justiceamoh/bioimpedancelab/eagle/analyzer/small_analyzer.pdf

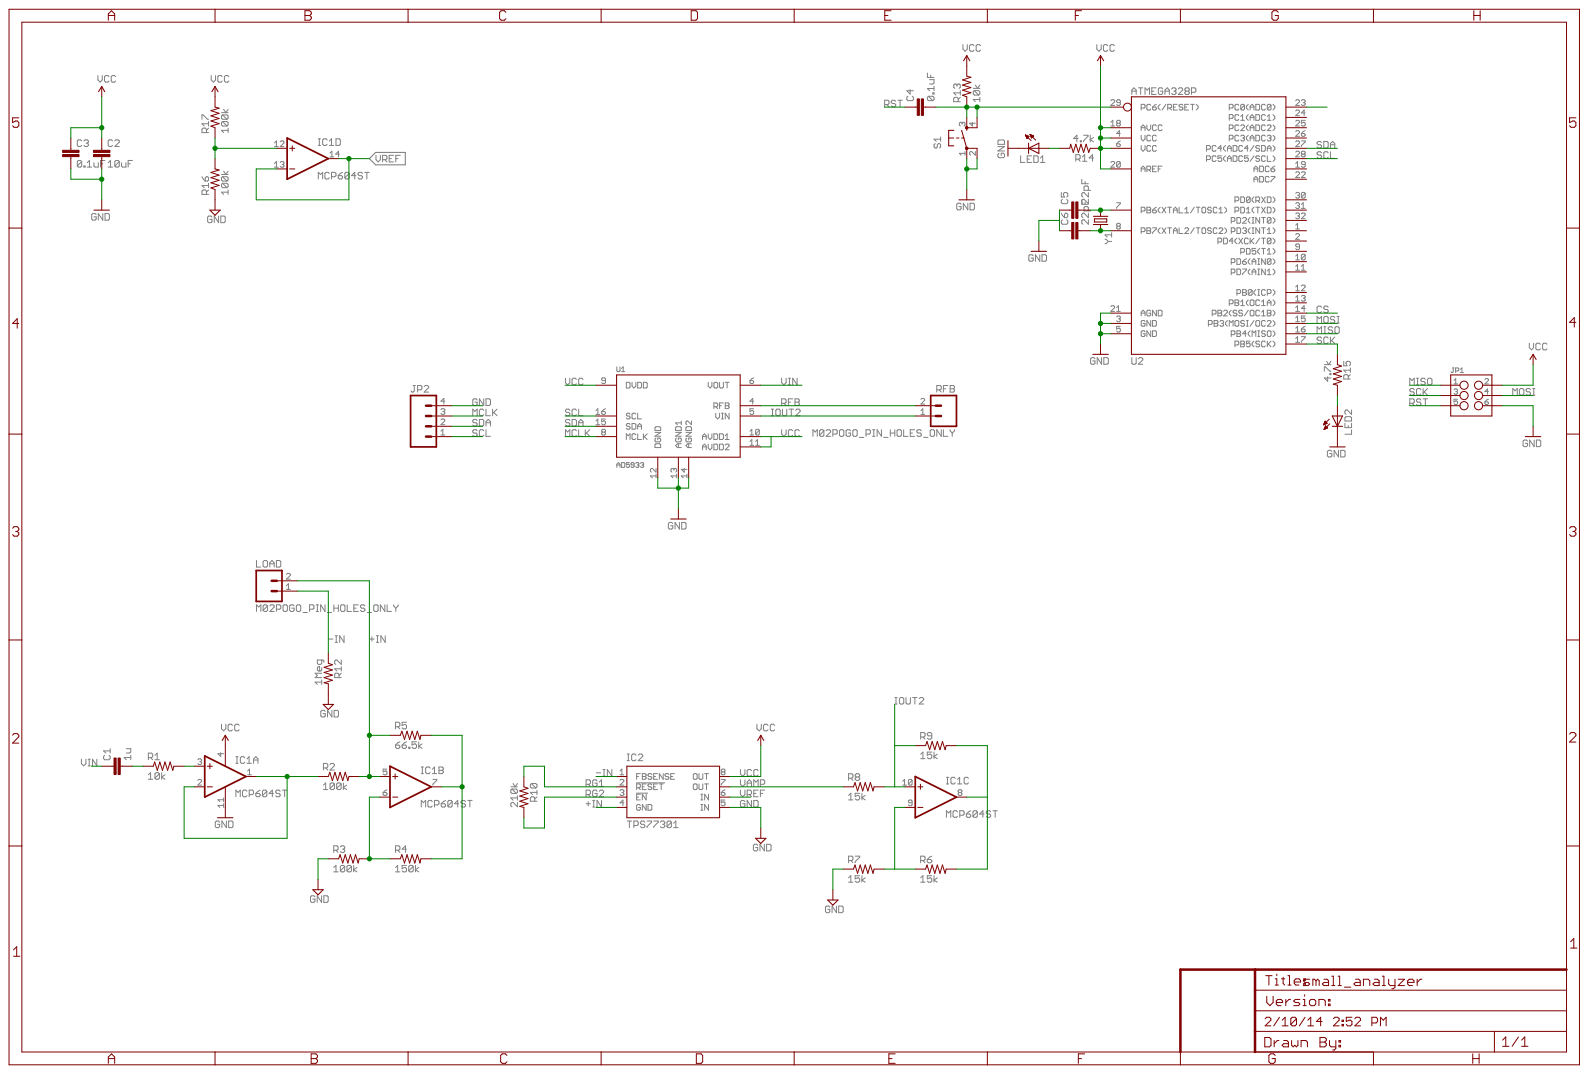
[picture p14: page 1]
