justiceamoh/bioimpedancelab/eagle/analyzer/small_analyzer.brd

## EAGLE design eagle/analyzer/small_analyzer.brd (2014-03-24)

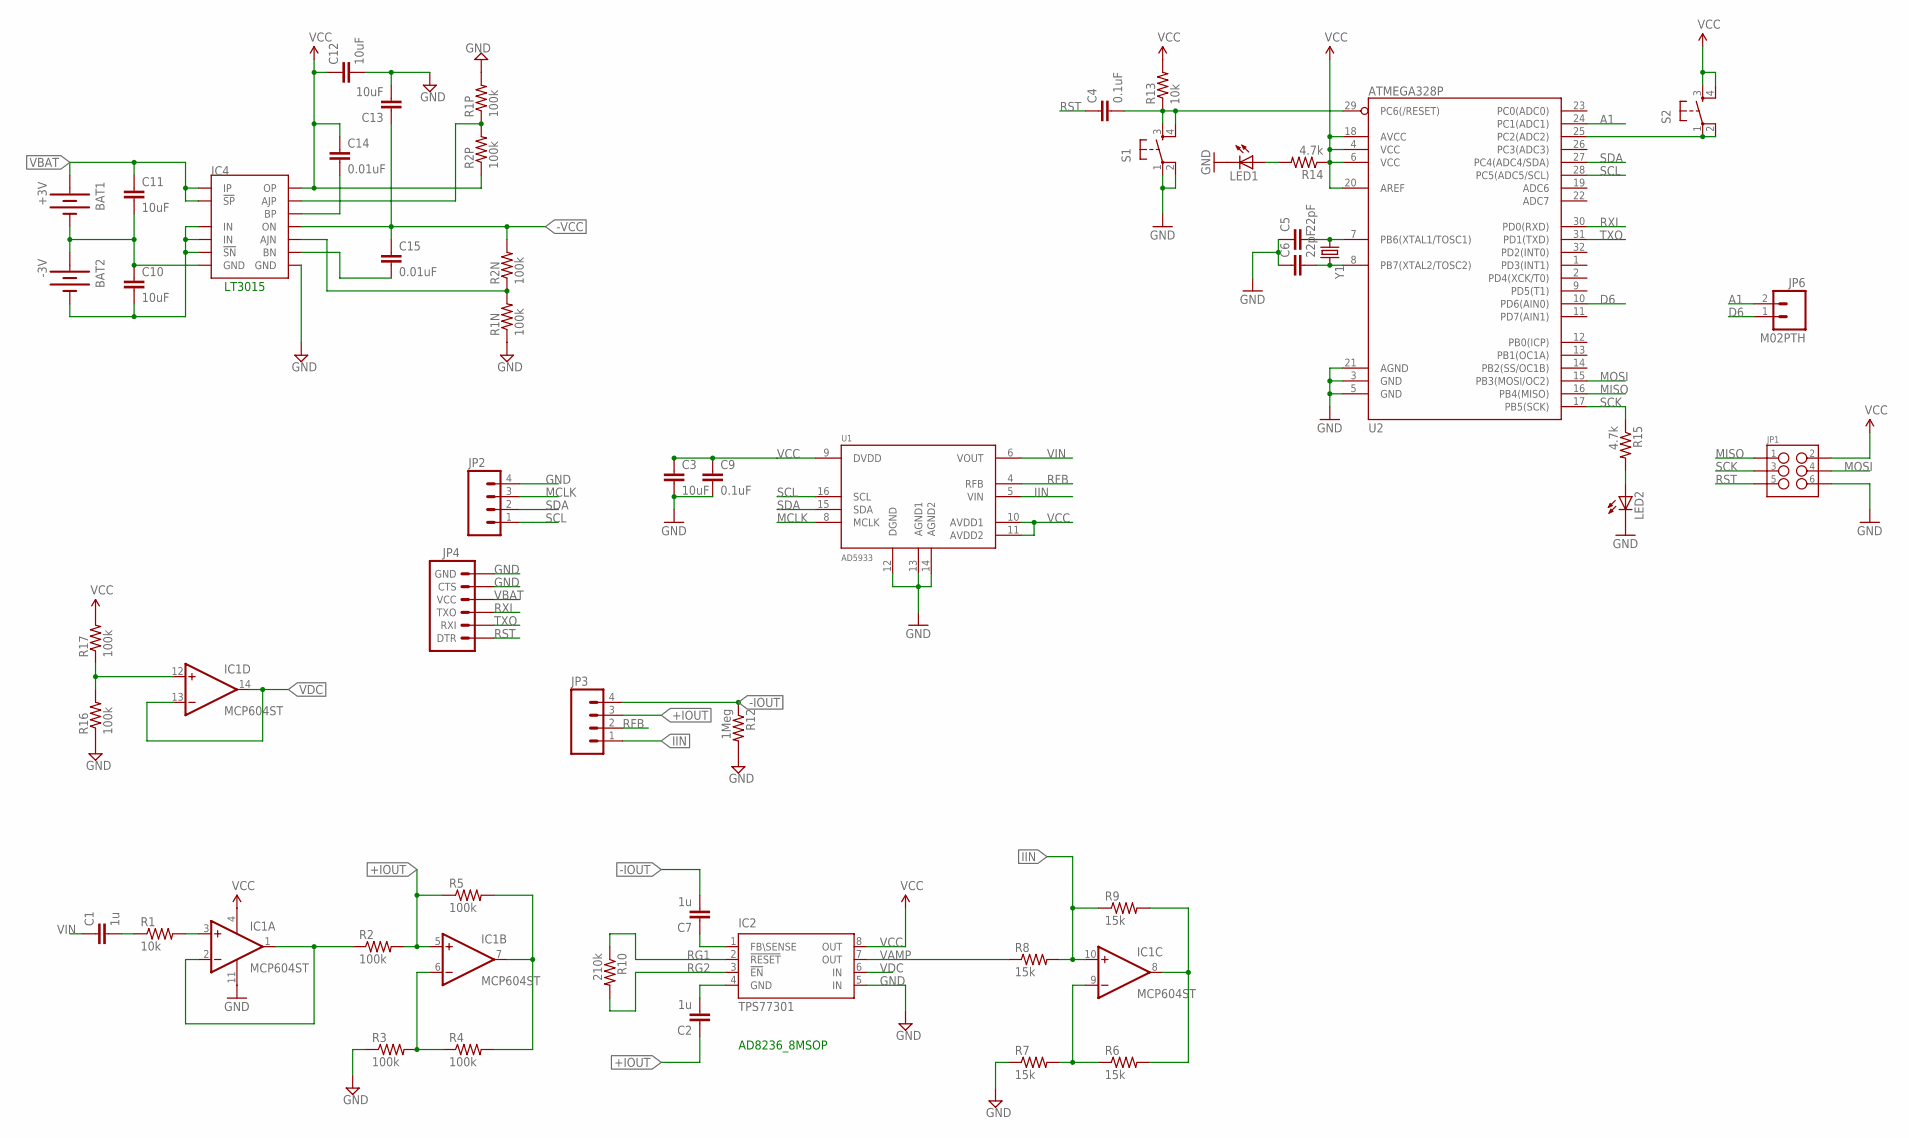
[picture p15: schematic small_analyzer.sch]

Parts:
BAT1: +3V; BATTCON_12MM
BAT2: -3V; BATTCON_12MM
C1, C2, C7: 1u; 0603-CAP
C3, C10, C11, C12, C13: 10uF; 0603-CAP
C4: 0.1uF; 0805
C5, C6: 22pF; 0805
C9: 0.1uF; 0603-CAP
C14, C15: 0.01uF; 0603-CAP
IC1: MCP604ST; TSSOP14
IC2: TPS77301; SOP-08
IC4: LT3032; DFN14-4X3DE
JP1: M03X2NO_SILK; 2X3-NS
JP2, JP3: M04PTH; 1X04
JP4: ARDUINO_SERIAL_PROGRAMLOCK; 1X06_LOCK
JP6: M02PTH; 1X02
LED1, LED2: LED0603; LED-0603
R1: 10k; 0603-RES
R1N, R1P, R2N, R2P, R16, R17: 100k; 0805
R2, R3, R4, R5: 100k; 0603-RES
R6, R7, R8, R9: 15k; 0603-RES
R10: 210k; 0603-RES
R12: 1Meg; 0603-RES
R13: 10k; 0805
R14, R15: 4.7k; 0805
S1, S2: TAC_SWITCHSMD; TACTILE_SWITCH_SMD
U1: AD5933; SSOP16
U2: ATMEGA328P; TQFP32-08
Y1: CRYSTAL5X3; CRYSTAL-SMD-5X3

Connections:
+IOUT: C2.1, IC1.5 (+IN), JP3.3, R2.2, R5.1
-IOUT: C7.2, JP3.4, R12.1
-VCC: C13.1, C15.1, IC4.7 (ON), R2N.2
A1: JP6.2, U2.24 (PC1(ADC1))
D6: JP6.1, U2.10 (PD6(AIN0))
GND: C3.2, C5.1, C6.1, C9.2, C12.2, C13.2, IC1.11 (V-), IC2.5 (IN), IC4.5 (GND), JP1.6, JP2.4, JP4.5 (CTS), JP4.6 (GND), LED1.C, LED2.C, R1N.1, R1P.2, R3.1, R7.1, R12.2, R16.1, S1.1, S1.2, U1.12 (DGND), U1.13 (AGND1), U1.14 (AGND2), U2.3 (GND), U2.5 (GND), U2.21 (AGND)
IIN: IC1.10 (+IN), JP3.1, R8.2, R9.1, U1.5 (VIN)
MCLK: JP2.3, U1.8 (MCLK)
MISO: JP1.1, U2.16 (PB4(MISO))
MOSI: JP1.4, U2.15 (PB3(MOSI/OC2))
unnamed: C1.2, R1.1
unnamed: IC1.3 (+IN), R1.2
unnamed: IC1.1 (OUT), IC1.2 (-IN), R2.1
unnamed: C5.2, U2.7 (PB6(XTAL1/TOSC1)), Y1.1
unnamed: IC1.6 (-IN), R3.2, R4.1
unnamed: IC1.7 (OUT), R4.2, R5.2
unnamed: IC1.8 (OUT), R6.2, R9.2
unnamed: IC1.9 (-IN), R6.1, R7.2
unnamed: C6.2, U2.8 (PB7(XTAL2/TOSC2)), Y1.3 (2)
unnamed: LED2.A, R15.2
unnamed: C4.2, R13.1, S1.3, S1.4, U2.29 (PC6(/RESET))
unnamed: LED1.A, R14.2
unnamed: BAT1.GND (-), BAT2.PWR@1 (+), C10.1, C11.2, IC4.4 (GND)
unnamed: IC1.12 (+IN), R16.2, R17.1
unnamed: S2.1, S2.2, U2.25 (PC2(ADC2))
unnamed: BAT2.GND (-), C10.2, IC4.6 (IN), IC4.9 (IN), IC4.10 (!SN)
unnamed: C14.2, IC4.3 (BP)
unnamed: C15.2, IC4.11 (BN)
unnamed: IC4.8 (AJN), R1N.2, R2N.1
unnamed: IC4.2 (AJP), R1P.1, R2P.2
unnamed: C7.1, IC2.1 (FB\SENSE)
unnamed: C2.2, IC2.4 (GND)
RFB: JP3.2, U1.4 (RFB)
RG1: IC2.2 (!RESET), R10.1
RG2: IC2.3 (!EN), R10.2
RST: C4.1, JP1.5, JP4.1 (DTR)
RXI: JP4.3 (TXO), U2.30 (PD0(RXD))
SCK: JP1.3, R15.1, U2.17 (PB5(SCK))
SCL: JP2.1, U1.16 (SCL), U2.28 (PC5(ADC5/SCL))
SDA: JP2.2, U1.15 (SDA), U2.27 (PC4(ADC4/SDA))
TXO: JP4.2 (RXI), U2.31 (PD1(TXD))
VAMP: IC2.7 (OUT), R8.1
VBAT: BAT1.PWR@1 (+), C11.1, IC4.12 (!SP), IC4.14 (IP), JP4.4 (VCC)
VCC: C3.1, C9.1, C12.1, C14.1, IC1.4 (V+), IC2.8 (OUT), IC4.1 (OP), JP1.2, R2P.1, R13.2, R14.1, R17.2, S2.3, S2.4, U1.9 (DVDD), U1.10 (AVDD1), U1.11 (AVDD2), U2.4 (VCC), U2.6 (VCC), U2.18 (AVCC), U2.20 (AREF)
VDC: IC1.13 (-IN), IC1.14 (OUT), IC2.6 (IN)
VIN: C1.1, U1.6 (VOUT)

Notes on the sheet:
AD8236_8MSOP
LT3015

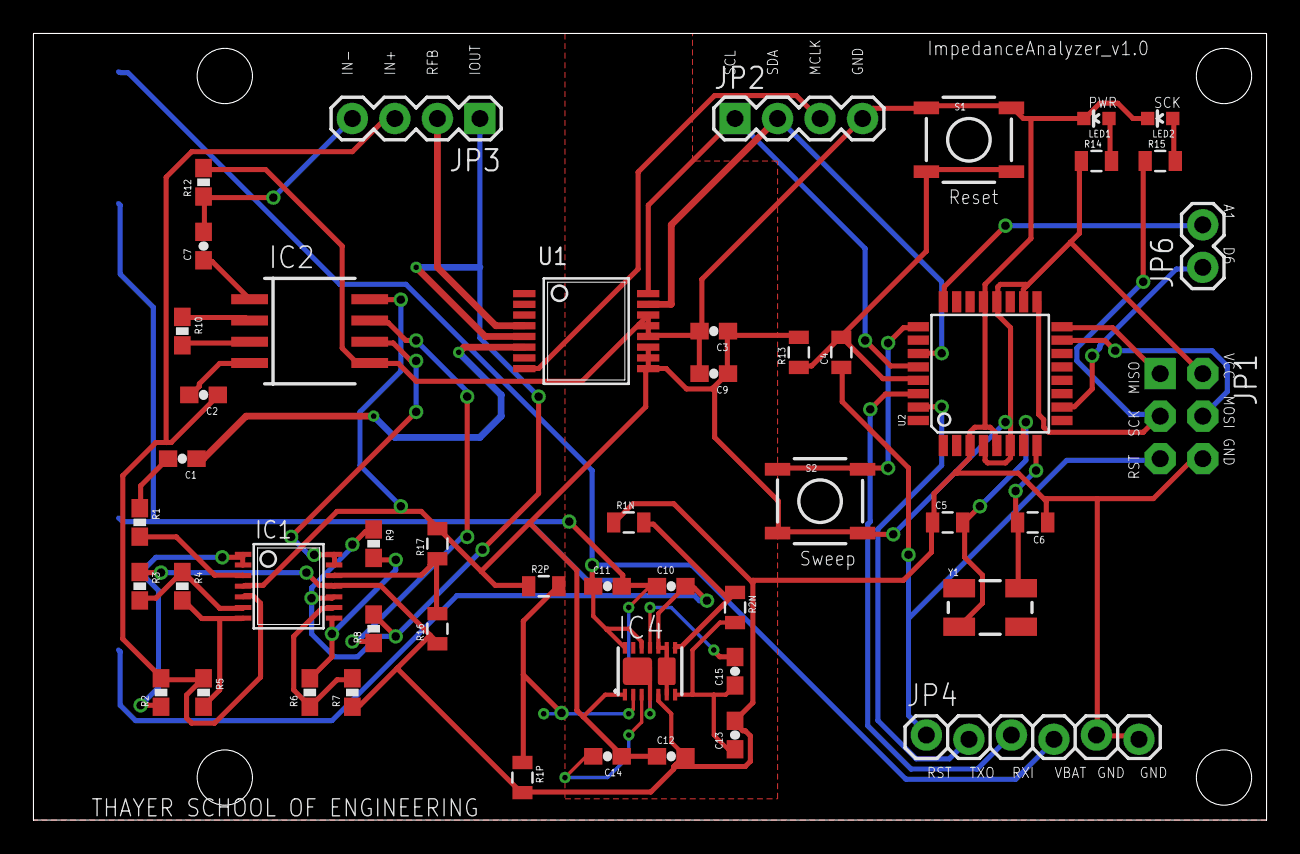
[picture p16: board small_analyzer.brd from above]

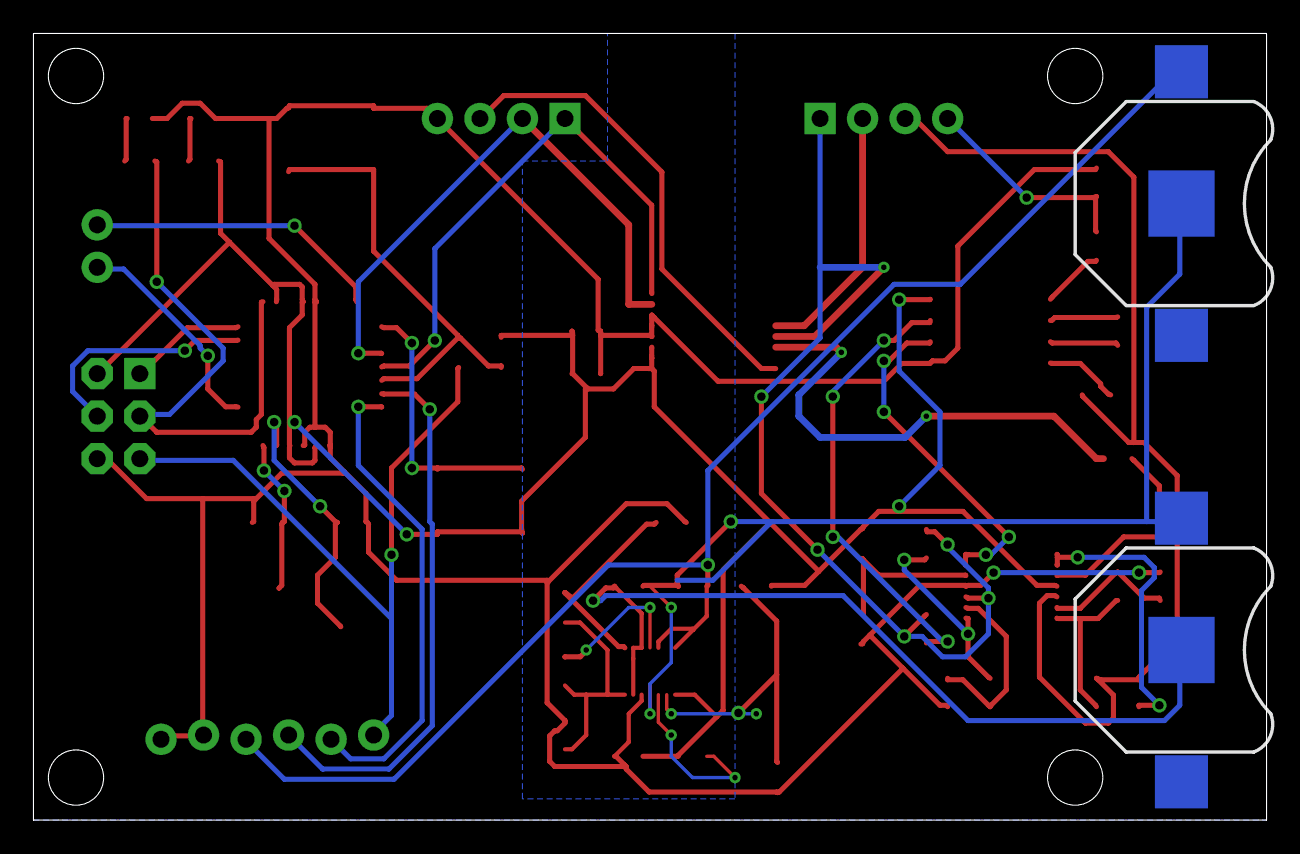
[picture p17: board small_analyzer.brd from below]

Board: 2 copper layers, 73.7 x 47.0 mm, 55 parts (2 on the bottom side), 46 nets.

Other parts of the board:
U$1, U$2, U$3, U$4: STAND-OFF
