justiceamoh/bioimpedancelab/eagle/ad5933_breakout/AD5933_Breakout.brd

## EAGLE design eagle/ad5933_breakout/AD5933_Breakout.brd (2014-02-03)

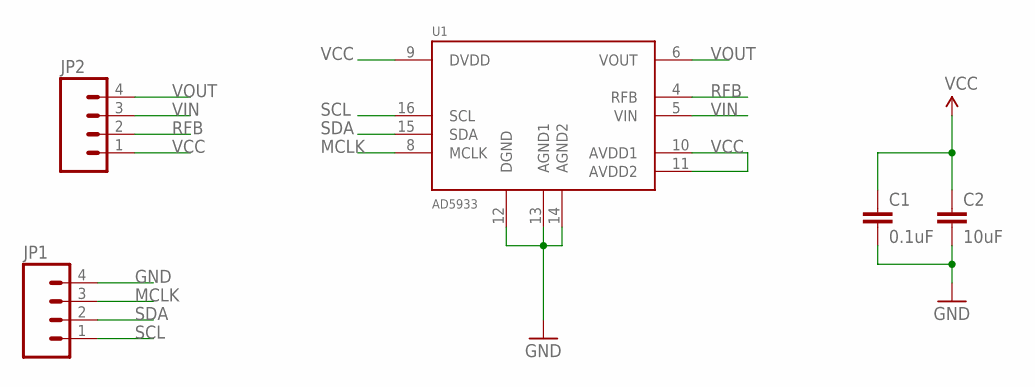
[picture p18: schematic AD5933_Breakout.sch]

Parts:
C1: 0.1uF; 0603-CAP
C2: 10uF; 0603-CAP
JP1, JP2: M04PTH; 1X04
U1: AD5933; SSOP16

Connections:
GND: C1.2, C2.2, JP1.4, U1.12 (DGND), U1.13 (AGND1), U1.14 (AGND2)
MCLK: JP1.3, U1.8 (MCLK)
RFB: JP2.2, U1.4 (RFB)
SCL: JP1.1, U1.16 (SCL)
SDA: JP1.2, U1.15 (SDA)
VCC: C1.1, C2.1, JP2.1, U1.9 (DVDD), U1.10 (AVDD1), U1.11 (AVDD2)
VIN: JP2.3, U1.5 (VIN)
VOUT: JP2.4, U1.6 (VOUT)

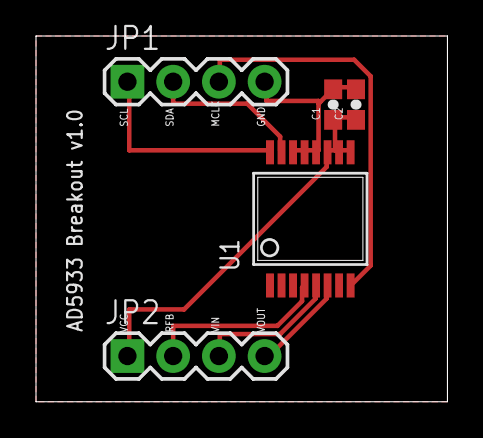
[picture p19: board AD5933_Breakout.brd from above]

Board: 2 copper layers, 22.9 x 20.3 mm, 5 parts (0 on the bottom side), 8 nets.
