justiceamoh/bioimpedancelab/maple/ic_control/HardWire.h

/* *****************************************************************************
 * The MIT License
 *
 * Copyright (c) 2010 LeafLabs LLC.
 *
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
 * THE SOFTWARE IS PROVIDED "AS IS", WITHOUT WARRANTY OF ANY KIND, EXPRESS OR
 * IMPLIED, INCLUDING BUT NOT LIMITED TO THE WARRANTIES OF MERCHANTABILITY,
 * FITNESS FOR A PARTICULAR PURPOSE AND NONINFRINGEMENT. IN NO EVENT SHALL THE
 * AUTHORS OR COPYRIGHT HOLDERS BE LIABLE FOR ANY CLAIM, DAMAGES OR OTHER
 * LIABILITY, WHETHER IN AN ACTION OF CONTRACT, TORT OR OTHERWISE, ARISING FROM,
 * OUT OF OR IN CONNECTION WITH THE SOFTWARE OR THE USE OR OTHER DEALINGS IN
 * THE SOFTWARE.
 * ****************************************************************************/

/**
 *  @brief Wire library, ported from Arduino. Provides a lean
 *  interface to I2C (two-wire) communication.
 */

#include "wirish.h"
#include "WireBase.h"

#ifndef _HARDWIRE_H_
#define _HARDWIRE_H_

#include "i2c.h"

class HardWire : public WireBase {
 private:
    i2c_dev* selhard;
 protected:
    uint8 process();
 public:
    HardWire(uint8, uint8);
    ~HardWire();
};

#endif // _WIRE_H_
