justiceamoh/bioimpedancelab/(commit log)

2013-10-09 initialized bioimpedance repo
    [AD5933_Breakout.sch]
2013-10-09 moved repo to thayer servers
    [AD5933_Breakout.sch]
2013-10-09 first iteration of board
    [AD5933_Breakout.brd, AD5933_Breakout.sch]
2013-10-09 both board and schematic looking good
    [AD5933_Breakout.brd, AD5933_Breakout.sch]
2013-10-09 first pcb routing
    [AD5933_Breakout.brd]
2013-10-09 rerouted board
    [AD5933_Breakout.brd]
2013-10-09 discovered downloaded ad5933 footprint is buggy
    [AD5933_Breakout.brd]
2013-10-10 clean up
    [AD5933_Breakout.brd]
2013-10-16 switched headers and rerouted all pins
    [AD5933_Breakout.brd, AD5933_Breakout.sch]
2013-10-16 fixed rules and cleared clearance errors
    [AD5933_Breakout.brd, AD5933_Breakout.sch]
2013-10-16 augmented size to fit on breadboard
    [AD5933_Breakout.brd]
2013-10-16 added gerber files
2013-10-23 added top and bottom copper pours to pcb
    [AD5933_Breakout.brd]
2013-10-25 created new gerber files
    [AD5933_Breakout.brd]
2013-10-25 pcb ordered
2013-10-28 added pcb order
2013-11-12 cleaned up temp.c and fixed minor bugs
    [temp.c]
2013-11-13 cleaned up arduino code to enable compile
2013-11-20 removed dependence on button press
2013-11-21 successfully reading temperature
2013-12-02 fixed interchanged RFB and VIN labels on board
    [AD5933_Breakout.brd]
2013-12-05 fixed temperature reading bug
    [sketch.cpp, sketch.ino, temp.ino]
2013-12-14 fixed bug that prevented subsequent sweeps
    [sketch.cpp, sketch.ino]
2014-01-28 troubleshoting arduino sketch, attempting to use ARM maple board, adding journal club papers
2014-02-03 added analyzer layout
    [AD5933_Breakout.brd, AD5933_Breakout.sch, small_analyzer.sch]
2014-02-03 added tetra_polar schematics
2014-02-03 added analyzer ic with mcu
    [AD5933_Breakout.sch, small_analyzer.brd, small_analyzer.sch]
2014-02-10 added ground planes, expanded board, changed mcu to atmega328
    [small_analyzer.brd, small_analyzer.sch]
2014-02-17 all pins successfully routed
    [small_analyzer.brd]
2014-02-23 updated howland circuit to right configuration for our purposes
2014-02-24 fixed drc laws
    [small_analyzer.brd, small_analyzer.sch]
2014-02-24 local updates
    [small_analyzer.brd]
2014-02-24 added sweep push button and decoupling caps
    [small_analyzer.brd, small_analyzer.sch]
2014-02-27 updates to circuit
2014-02-27 added fast opamp datasheet and changes to howland circuit
2014-03-20 updates to howland circuits
2014-03-20 added dual voltage regulator to board
    [small_analyzer.brd, small_analyzer.sch]
2014-03-20 updated schematic to dual voltage regulator, errors in board
    [small_analyzer.brd, small_analyzer.sch]
2014-03-24 analyzer version 1 as submitted for pcb fab
    [small_analyzer.brd, small_analyzer.sch]
2014-05-01 fixed calibration bug
    [small_analyzer.sch]
2014-05-01 very well calibrated
